meco-group/mecotron/README.md

# mecotron

This repository gathers software and hardware details on mobile platforms that were recently designed in support of an introductory control course.

Through dedicated assignments, students are guided to implement and validate all parts of the course on a setup, ranging from basic time-domain system identification, over root locus analysis and loop shaping PID design, to state feedback, state estimation and Kalman filtering.

The designed platforms are flexible, allowing for numerous extensions and variations; cheap, allowing for a large pool of setups from which the students can borrow platforms to take home; and of sufficient quality, allowing the students to get maximal insight in the course material.

The platforms are furthermore easy to set up and administer using the supporting material.

*These set-ups were presented at the demonstrator sessions at the 20th IFAC World Congress (Toulouse, 2017); see [the accompanying paper](https://www.sciencedirect.com/science/article/pii/S240589631732325X) and the video below.*

<p align="center">
<a href="https://www.youtube.com/watch?v=29Rf3V9_PGU">
Spline-based motion planning
</a>
</p>
