meco-group/mecotron/assignments/figures/1dcart.pdf

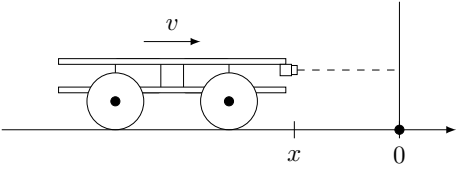
[picture p3: figure]
