meco-group/mecotron/hardware/mega_meco_schematics/mega_meco_rev3.png

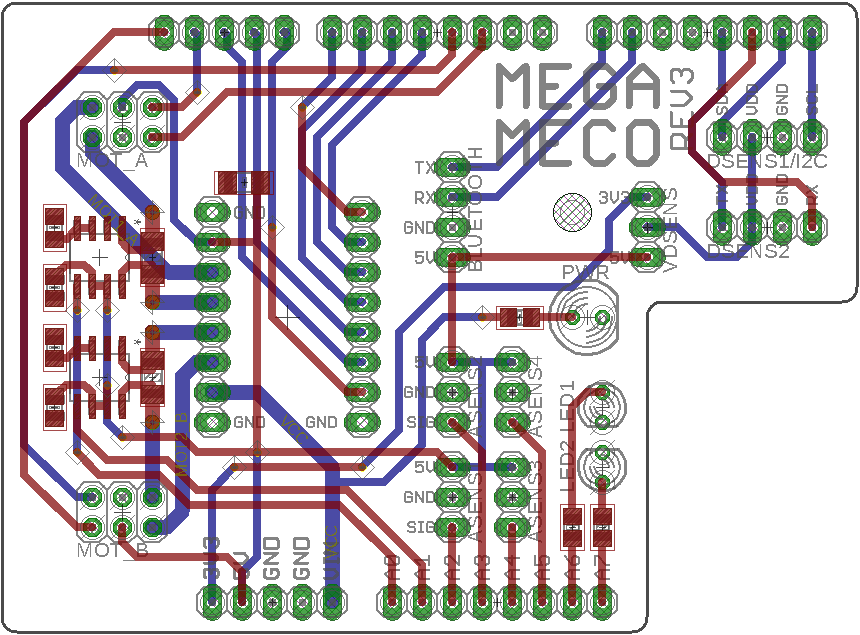
hardware/mega_meco_schematics/mega_meco_rev3.png
