meco-group/mecotron/software/Desktop/QRoboticsCenter.png

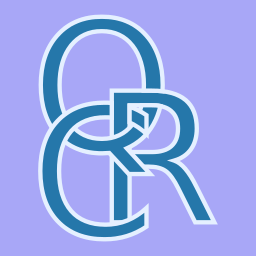
software/Desktop/QRoboticsCenter.png
