meco-group/mecotron/hardware/parts_list/parts_list.pdf

# Platforms: parts list

## 1 Mechanical parts

Table 1 comprises all the parts that are shared by the two types of platforms.

Item No. | Description | Qty. | Remarks
1 | MDF lower frame basis | 1 | 3mm MDF
2 | MDF upper frame basis | 1 | 3mm MDF
3 | MDF motor slide | 2 | 3mm MDF
4 | MDF rear slide | 2 | 3mm MDF
5 | MDF fork | 2 | 3mm MDF, to lock MDF rear slide
6 | Spacer | 6 | M3x30mm
7 | Screw | 24 | M3x10mm; 12 for spacers, 4 for motors, 2 for number plate, 4 for Arduino, 2 for IR sensor
8 | Nut | 8 | M3; 2 for number plate, 4 for Arduino, 2 for IR sensor
9 | DC motor + gearbox + encoder | 2 | 12V, 157rpm
10 | Motor terminal connector | 2
11 | Zip tie | 2 | 100mm, to fix the motors to the lower frame
12 | Wheel hub | 2 | 4mm drill, 12mm hexagon
13 | Set screw for wheel hub | 2
14 | RC wheel | 2 | 65mm x 25mm
15 | Screw | 2 | M4x10mm; to fix the wheel to the hub
16 | Washer | 2 | M4; between wheel and M4 screw
17 | IR sensor | 1 | Sharp GP2Y0A41SK0F, 4-30cm
18 | IR sensor mounting bracket | 1
19 | IR sensor terminal connector | 1
20 | MDF IR sensor support | 1
21 | MDF number plate | 1
22 | Arduino MEGA 2560 | 1
23 | MEGA MECO breakout board | 1 | for details see Table ??
24 | Power supply | 1 | 12V, 24W
25 | USB cable | 1 | male USB-1.0 type B to male USB-2.0 type A

Table 1: Shared parts

Table 2 comprises the parts that are additionally needed to build a swivel platform.

Item No. | Description | Qty. | Remarks
101 | Screw | 6 | M3x10mm; 2 for IR sensor, 4 for swivel caster wheel
102 | Nut | 6 | M3; 2 for IR sensor, 4 for swivel caster wheel
103 | Swivel caster wheel | 1 | 25mm, overall height approx. 30mm
104 | IR sensor | 1 | Sharp GP2Y0A41SK0F, 4-30cm
105 | IR sensor mounting bracket | 1 | 90◦ angle
106 | IR sensor terminal connector | 1
107 | MDF IR sensor support | 1

Table 2: Additional parts for swivel version

Table 3 comprises the parts that are additionally needed to build a pendulum platform.

Item No. | Description | Qty. | Remarks
201 | MDF pendulum rack | 1 | 2 A-shaped slides and a connecting plate
202 | MDF pendulum | 1 | 5mm MDF
203 | MDF fork | 6 | 3mm MDF, to lock the pendulum rack
204 | Potentiometer | 1 | Vishay 157B503MX
205 | Potentiometer terminal connector | 1
206 | Rear axle | 1 | 4mm, 150mm
207 | Bearing | 2 | 4x7x2mm, fitted into bore of MDF rear slide
208 | Wheel hub | 2 | 4mm drill to 12mm hexagon
209 | Set screw | 2 | M4x6mm; for wheel hub
210 | RC wheel | 2 | 65mm x 25mm
211 | Screw | 2 | M4x10mm; to fix the wheel to the hub
212 | Washer | 2 | M4; between wheel and screw

Table 3: Additional parts for pendulum version

## 2 MEGA MECO parts

Refer to the BOM/parts list from Eagle schematics.
