meco-group/mecotron/assignments/figures/cart_kalman.pdf

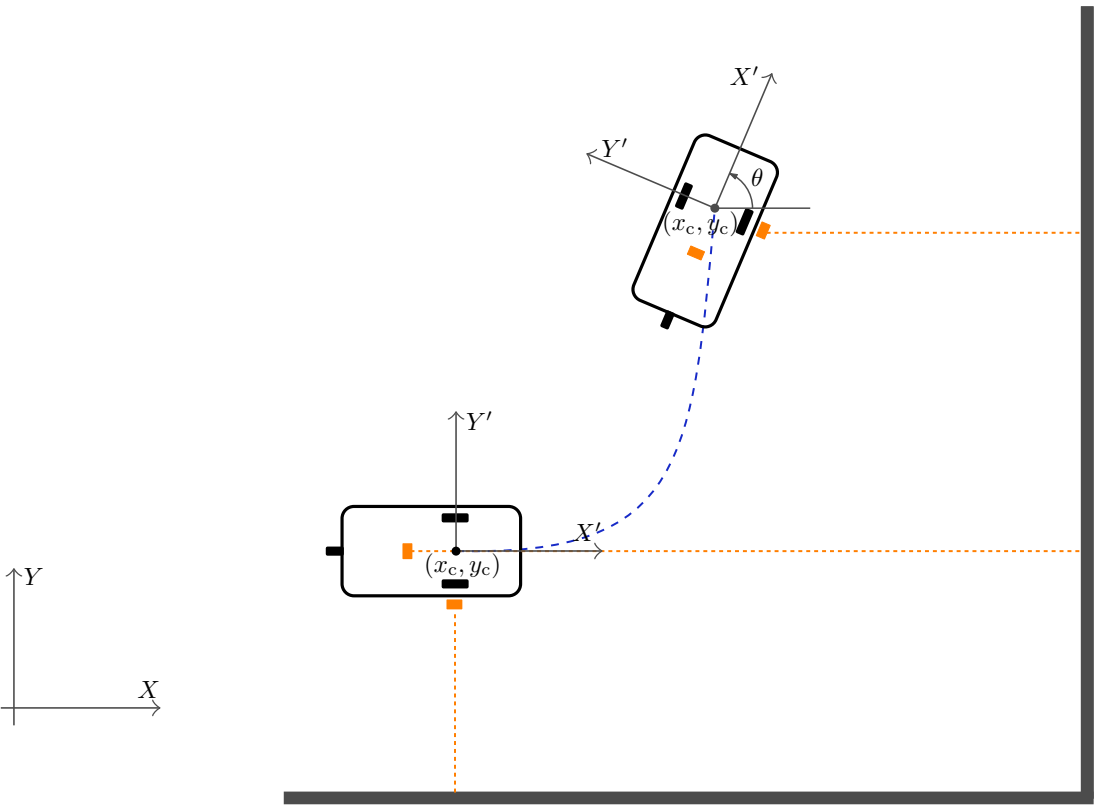
[picture p6: page 1]
