meco-group/mecotron/assignments/figures/illustration_kalman.pdf

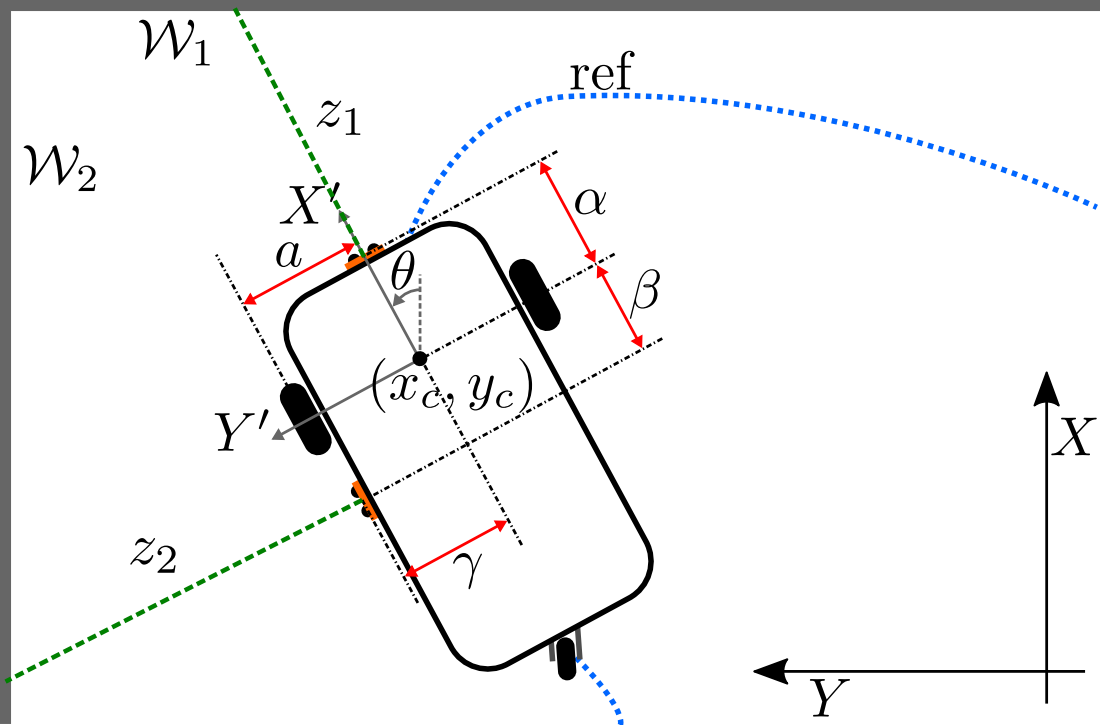
[picture p7: page 1]
