meco-group/mecotron/hardware/mega_meco_schematics/mega_meco.brd

## EAGLE design hardware/mega_meco_schematics/mega_meco.brd (2016-11-30, last stored version)

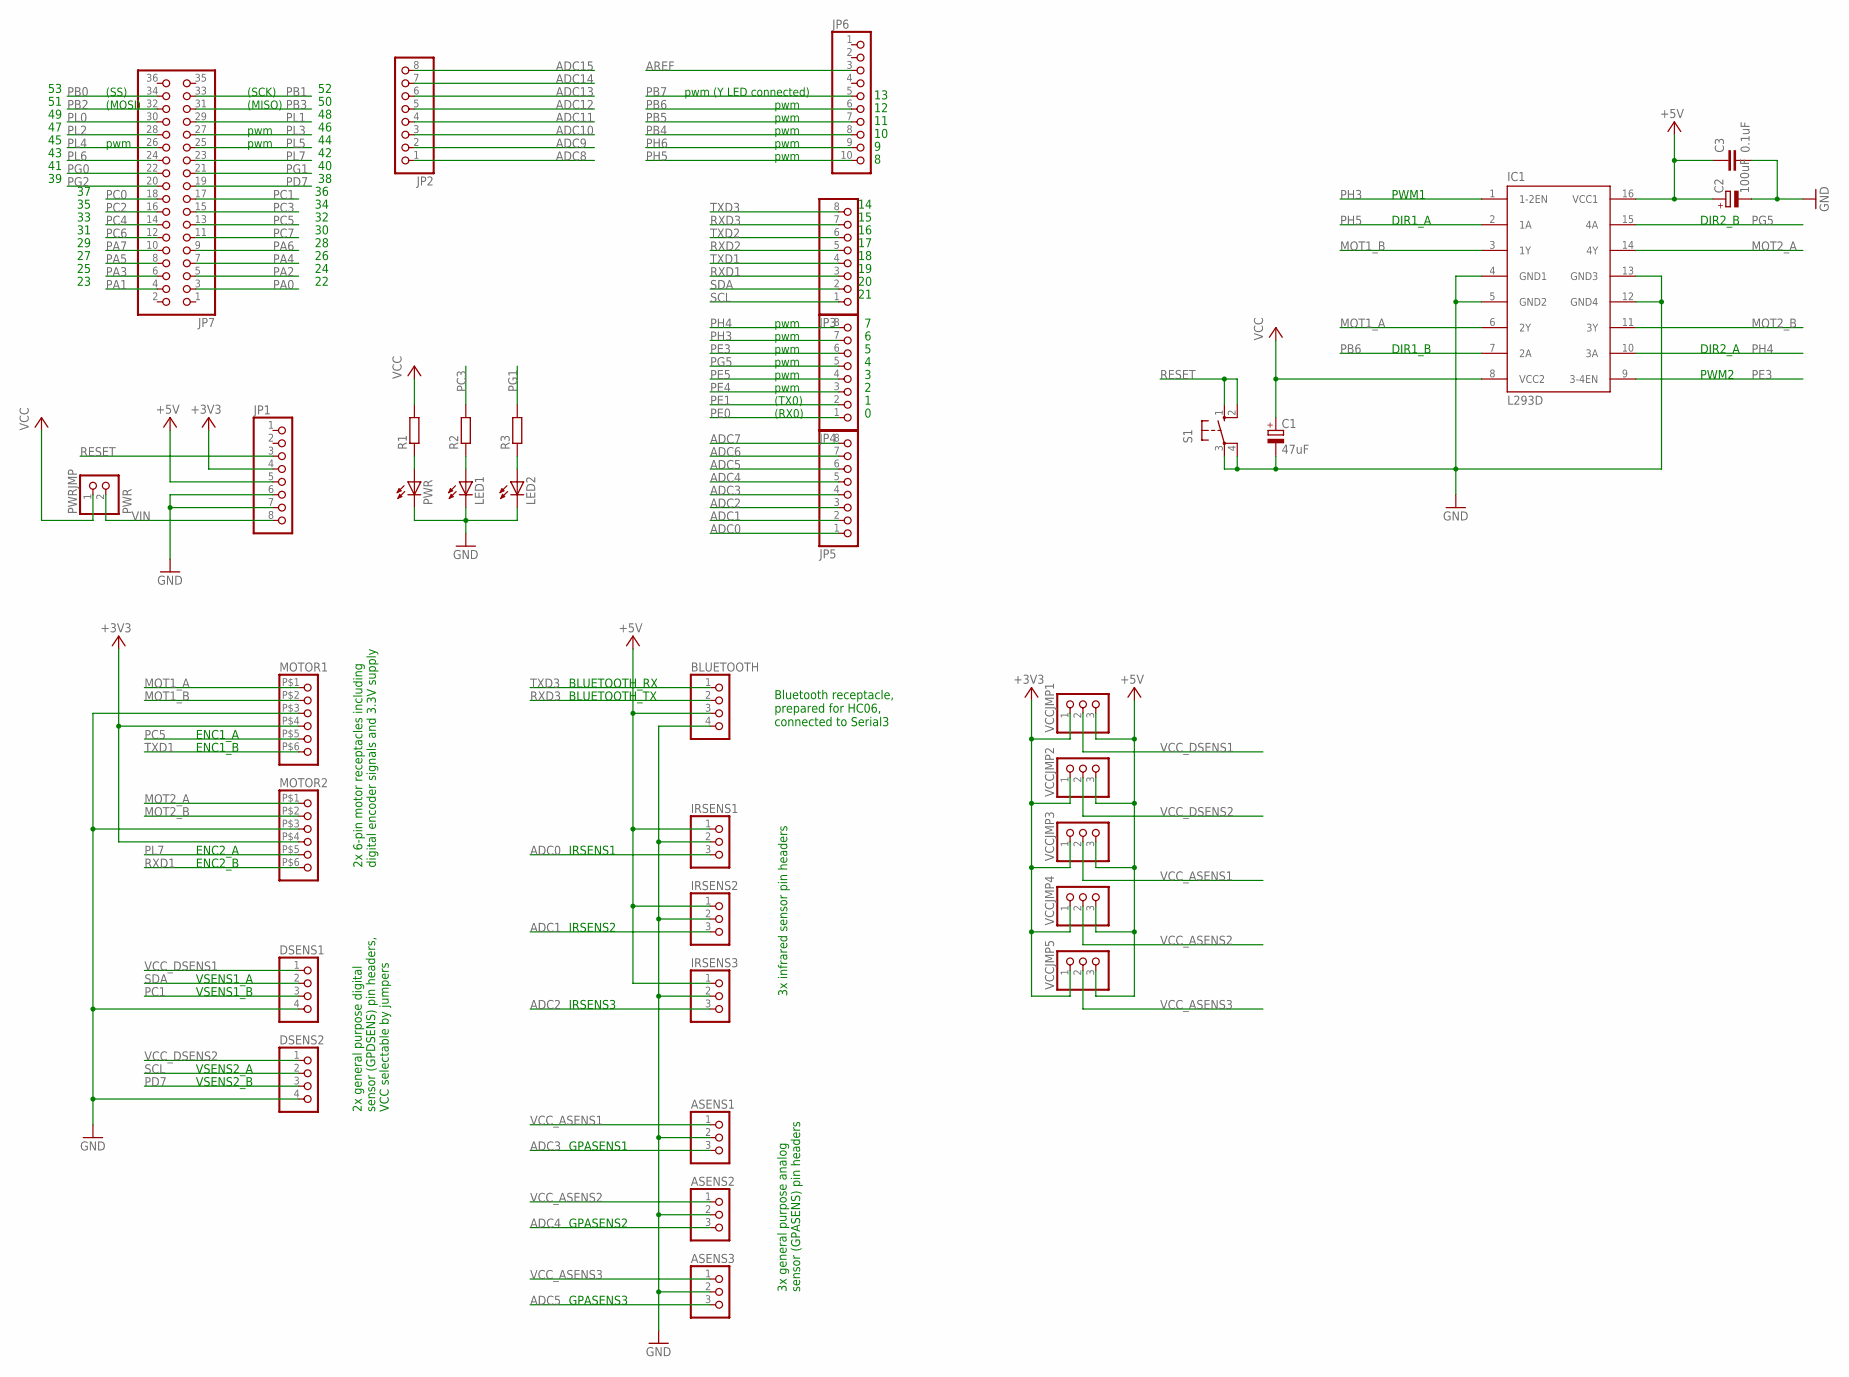
[picture p8: schematic mega_meco.sch]

Parts:
ASENS1, ASENS2, ASENS3: PINHD-1X3; 1X03
BLUETOOTH: PINHD-1X4; 1X04
C1: 47uF; E2-5
C2: 100uF; E2-5
C3: 0.1uF; C025-025X050
DSENS1, DSENS2: PINHD-1X4; 1X04
IC1: L293D; DIL16
IRSENS1, IRSENS2, IRSENS3: PINHD-1X3; 1X03
JP1, JP2, JP3, JP4, JP5: PINHD-1X8; 1X08
JP6: PINHD-1X10; 1X10
JP7: PINHD-2X18; 2X18
LED1, LED2: LED3MM
MOTOR1, MOTOR2: PINHD-1X6-2.5MM; 1X06-2.5MM
PWR: LED5MM
PWRJMP: PWR; 1X02
R1, R2, R3: R-EU_0204/5; 0204/5
S1: 10-XX; B3F-10XX
VCCJMP1, VCCJMP2, VCCJMP3, VCCJMP4, VCCJMP5: PINHD-1X3; 1X03

Connections:
+3V3: JP1.4, MOTOR1.P$4 (4), MOTOR2.P$4 (4), VCCJMP1.1, VCCJMP2.1, VCCJMP3.1, VCCJMP4.1, VCCJMP5.1
+5V: BLUETOOTH.3, C2.+, C3.1, IC1.16 (VCC1), IRSENS1.1, IRSENS2.1, IRSENS3.1, JP1.5, VCCJMP1.3, VCCJMP2.3, VCCJMP3.3, VCCJMP4.3, VCCJMP5.3
ADC0: IRSENS1.3, JP5.1
ADC1: IRSENS2.3, JP5.2
ADC2: IRSENS3.3, JP5.3
ADC3: ASENS1.3, JP5.4
ADC4: ASENS2.3, JP5.5
ADC5: ASENS3.3, JP5.6
ADC6: JP5.7
ADC7: JP5.8
ADC8: JP2.1
ADC9: JP2.2
ADC10: JP2.3
ADC11: JP2.4
ADC12: JP2.5
ADC13: JP2.6
ADC14: JP2.7
ADC15: JP2.8
AREF: JP6.3
GND: ASENS1.2, ASENS2.2, ASENS3.2, BLUETOOTH.4, C1.-, C2.-, C3.2, DSENS1.4, DSENS2.4, IC1.4 (GND1), IC1.5 (GND2), IC1.12 (GND4), IC1.13 (GND3), IRSENS1.2, IRSENS2.2, IRSENS3.2, JP1.6, JP1.7, LED1.K (C), LED2.K (C), MOTOR1.P$3 (3), MOTOR2.P$3 (3), PWR.K (C), S1.3, S1.4 (P1)
MOT1_A: IC1.6 (2Y), MOTOR1.P$1 (1)
MOT1_B: IC1.3 (1Y), MOTOR1.P$2 (2)
MOT2_A: IC1.14 (4Y), MOTOR2.P$1 (1)
MOT2_B: IC1.11 (3Y), MOTOR2.P$2 (2)
unnamed: PWR.A, R1.1
unnamed: LED1.A, R2.1
unnamed: LED2.A, R3.1
PA0: JP7.3
PA1: JP7.4
PA2: JP7.5
PA3: JP7.6
PA4: JP7.7
PA5: JP7.8
PA6: JP7.9
PA7: JP7.10
PB0: JP7.34
PB1: JP7.33
PB2: JP7.32
PB3: JP7.31
PB4: JP6.8
PB5: JP6.7
PB6: IC1.7 (2A), JP6.6
PB7: JP6.5
PC0: JP7.18
PC1: DSENS1.3, JP7.17
PC2: JP7.16
PC3: JP7.15, R2.2
PC4: JP7.14
PC5: JP7.13, MOTOR1.P$5 (5)
PC6: JP7.12
PC7: JP7.11
PD7: DSENS2.3, JP7.19
PE0: JP4.1
PE1: JP4.2
PE3: IC1.9 (3-4EN), JP4.6
PE4: JP4.3
PE5: JP4.4
PG0: JP7.22
PG1: JP7.21, R3.2
PG2: JP7.20
PG5: IC1.15 (4A), JP4.5
PH3: IC1.1 (1-2EN), JP4.7
PH4: IC1.10 (3A), JP4.8
PH5: IC1.2 (1A), JP6.10
PH6: JP6.9
PL0: JP7.30
PL1: JP7.29
PL2: JP7.28
PL3: JP7.27
PL4: JP7.26
PL5: JP7.25
PL6: JP7.24
PL7: JP7.23, MOTOR2.P$5 (5)
RESET: JP1.3, S1.1 (S), S1.2 (S1)
RXD1: JP3.3, MOTOR2.P$6 (6)
RXD2: JP3.5
RXD3: BLUETOOTH.2, JP3.7
SCL: DSENS2.2, JP3.1
SDA: DSENS1.2, JP3.2
TXD1: JP3.4, MOTOR1.P$6 (6)
TXD2: JP3.6
TXD3: BLUETOOTH.1, JP3.8
VCC: C1.+, IC1.8 (VCC2), PWRJMP.1, R1.2
VCC_ASENS1: ASENS1.1, VCCJMP3.2
VCC_ASENS2: ASENS2.1, VCCJMP4.2
VCC_ASENS3: ASENS3.1, VCCJMP5.2
VCC_DSENS1: DSENS1.1, VCCJMP1.2
VCC_DSENS2: DSENS2.1, VCCJMP2.2
VIN: JP1.8, PWRJMP.2

Notes on the sheet:
pwm (Y LED connected)
pwm
(TX0)
(RX0)
(SS)
(MOSI)
(SCK)
(MISO)
BLUETOOTH_RX
BLUETOOTH_TX
IRSENS1
IRSENS2
IRSENS3
GPASENS1
VSENS1_A
VSENS1_B
VSENS2_A
VSENS2_B
ENC2_A
ENC2_B
ENC1_A
ENC1_B
PWM1
DIR1_A
DIR1_B
DIR2_B
DIR2_A
PWM2
Bluetooth receptacle, prepared for HC06, connected to Serial3
3x infrared sensor pin headers
2x general purpose digital sensor (GPDSENS) pin headers, VCC selectable by jumpers
GPASENS2
GPASENS3
3x general purpose analog sensor (GPASENS) pin headers
2x 6-pin motor receptacles including digital encoder signals and 3.3V supply

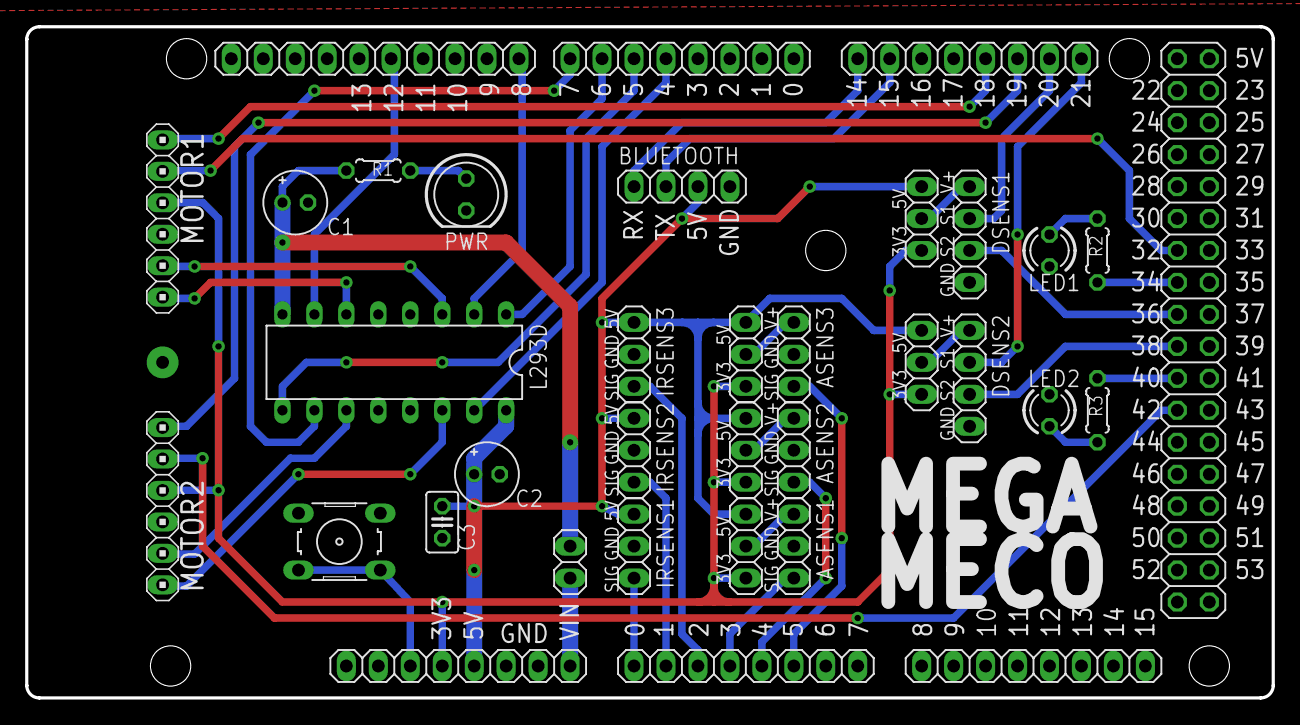
[picture p9: board mega_meco.brd from above]

Board: 2 copper layers, 99.1 x 53.3 mm, 35 parts (0 on the bottom side), 42 nets.
