meco-group/mecotron/(commit log)

2016-11-30 Add hardware details
    [mega_meco.brd, mega_meco.sch]
2017-01-13 Pack Eagle files
    [mega_meco.brd, mega_meco.sch]
